SebiSebi/PM_project_F8_car/results/Pirtoaca_GeorgeSebastian_20170520_212222.jpg

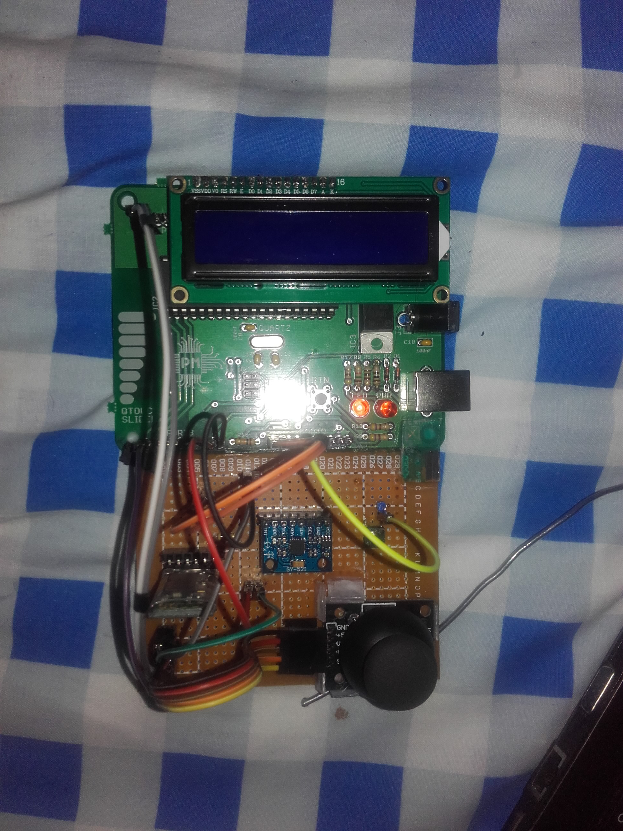
results/Pirtoaca_GeorgeSebastian_20170520_212222.jpg
