SebiSebi/PM_project_F8_car/M3/Milestone3_Pirtoaca_GeorgeSebastian_335CB.pdf

2017/05/13 23:45 | 1/5 | George-Sebastian PÎRTOAC (66847) - Fast and Furious


PM Wiki - http://cs.curs.pub.ro/wiki/pm/

# George-Sebastian PÎRTOAC (66847) - Fast and Furious

Autorul poate fi contactat la adresa: gpirtoaca@gmail.com

## Introducere

Proiectul are ca scop realizarea unei masinute cu telecomanda ce detecteaza obstacolele frontale si nu permite accidente in acest sens. De asemenea, masinuta va dispune si de un claxon pentru atentionarea diferitelor situatii in trafic . Controlul masinii se va face prin inclinarea telecomenzii in anumite unghiuri si pe anumite directii (alese in mod natural, pentru un control cat mai facil). De asemenea, restul comenzilor catre masinuta (precum claxon) se vor da tot cu ajutorul unor butoane plasate pe telecomanda. Comunicatia intre telecomanda si masinuta se va realiza prin tehnologia Bluetooth. Ideea acestui proiect provine din seria de filme de actiune The Fast and the Furious (https://en.wikipedia.org/wiki/The_Fast_and_the_Furious) a carei ultima pelicula abia a fost lansata in cinematografe. Proiectul este util pentru a invata cum se interfateaza diferitele componente pe care le voi utiliza (precum modulul de Bluetooth) cu un microcontroler dar si pentru a-mi cultiva pasiunea pentru masini

## Descriere general

Fig. 1: Schema bloc pentru telecomanda

Comunicatia intre microcontroler si modulul de bluetooth se face prin interfata seriala USART. Modulul de Bluetooth lucreaza in modul master si transmite comenzi cate modulul de Bluetooth de pe masinuta (care, implicit, va fi slave). Periodic, uC citeste datele de la accelerometru, folosind pinii conectati la convertorul analogic-digital, pentru a sesiza eventualele schimbari si pentru a transmite comenzile corespunzatoare catre microcontrolerul de pe masinuta. Microcontrolerul va lua decizii pe baza a doua unghiuri pe care acesta le poate masura (unghiul din planul XoY nu poate fi masurat doar

Last
update:
2017/05/13
23:41

prj2017:anitu:masinuta_pirtoaca_george_sebastian_335cb_2017 http://cs.curs.pub.ro/wiki/pm/prj2017/anitu/masinuta_pirtoaca_george_sebastian_335cb_2017


http://cs.curs.pub.ro/wiki/pm/ | Printed on 2017/05/13 23:45

pe baza accelerometrului, dar doua unghiuri sunt suficiente). Pentru mai multe detalii se pot consulta: Unghiurile lui Euler (https://en.wikipedia.org/wiki/Euler_angles) si Axele unui avion. (https://en.wikipedia.org/wiki/Aircraft_principal_axes) Unul dintre aceste unghiuri va da acceleratia masinii iar celalat directia. Date importante vor fi afisate pe LCD (in functie si de timpul extra de care dispun pentru implementarea proiectului pot sa adaug anumite feature-uri bonus precum: masurarea vitezei masinii, muzica la bord).

Fig. 2: Schema bloc pentru masina

Masinuta va avea 4 motoare (2 fata si 2 spate) - 4×4 iar directia se va modifica prin schimbarea vitezei de rotatie a rotilor de pe o parte sau alta a masinii. Pentru a asigura curentul necesar consumat de cele 4 motoare am ales sa folosesc driverul L298N. Acesta trebuie alimentat la o tensiune mai mare sau egala cu 9V (eu am ales sa folosesc 12V) si poate fi controlat folosind PWM pentru a modifica turatia motoarelor. Modulul de Bluetooth lucreaza in mod slave si asteapta date de la telecomanda. Microcontrolerul discuta cu un sensor de distanta (care va fi amplasat frontal) pentru a putea evita eventualele coliziuni ale masinutei (cand se detecteaza obiecte la o anumita distanta, aproximativ 20cm, masinuta nu va mai inainta). Buzzer-ul este folosit pentru implementarea claxonului.

## Hardware Design

Lista de piese:

2017/05/13 23:45 | 3/5 | George-Sebastian PÎRTOAC (66847) - Fast and Furious
Nume | Distribuitor
Placa de baza PM 2017 | Echipa PM
Modul Bluetooth HC-05 | Optimus Digital (https://www.optimusdigital.ro/wireless-bluetooth/153-modul-bluetooth-master-slave-hc-05-cu-adaptor.html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)
Motor cu reductor, cuplu 0.8 kg * cm | Optimus Digital
Buzzer | Optimus Digital (https://www.optimusdigital.ro/audio-buzzere/633-buzzer-activ-de-5-v.html?search_query=buzzer&results=20)
Driver motoare L298N | Optimus Digital (https://www.optimusdigital.ro/drivere-de-motoare-cu-perii/145-driver-de-motoare-dual-l298n.html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)
Senzor ultrasonic HC-SR04 | Optimus Digital (https://www.optimusdigital.ro/senzori-senzori-ultrasonici/9-senzor-ultrasonic-hc-sr04-.html)
LCD 16×2 | Robofun (https://www.robofun.ro/lcd/lcd-16x2-alb-albastru-3v)
Sasiu si roti | Optimus Digital (https://www.optimusdigital.ro/robotica-kit-uri-de-roboti/2042-kit-robot-cu-4-motoare-albastru.html)
Fire mama-mama | Optimus Digital (https://www.optimusdigital.ro/fire-fire-mufate/883-set-fire-mama-mama-10p-30-cm.html)
Fire mama-tata | Optimus Digital (https://www.optimusdigital.ro/fire-fire-mufate/879-set-fire-mama-tata-10p-30-cm.html)
Rezistente | Optimus Digital
Condensatoare | Optimus Digital
Acumulatori | Optimus Digital
Modul Accelerometru Digital MMA8452 Optimus Digital (https://www.optimusdigital.ro/senzori-senzori-inertiali/748-modul-accelerometru-digital-mma8452.html)

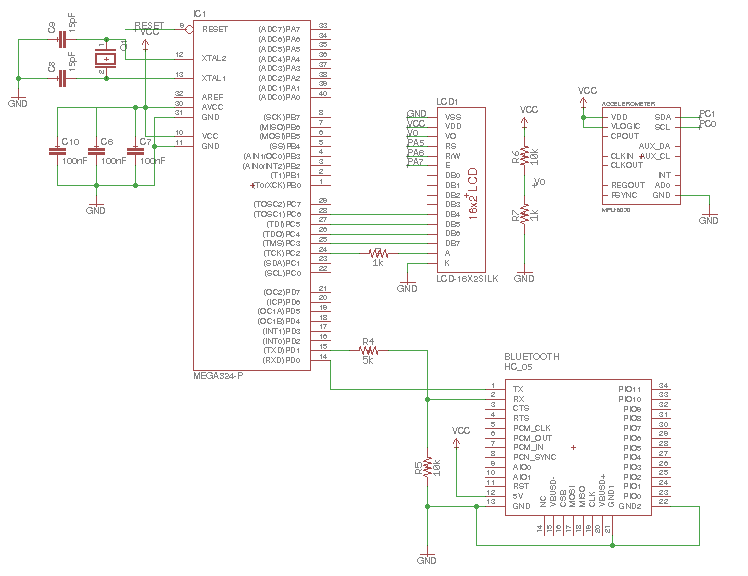
[picture p6: figure]

Fig. 3: Schema electrica pentru telecomanda

Last
update:
2017/05/13
23:41

prj2017:anitu:masinuta_pirtoaca_george_sebastian_335cb_2017 http://cs.curs.pub.ro/wiki/pm/prj2017/anitu/masinuta_pirtoaca_george_sebastian_335cb_2017

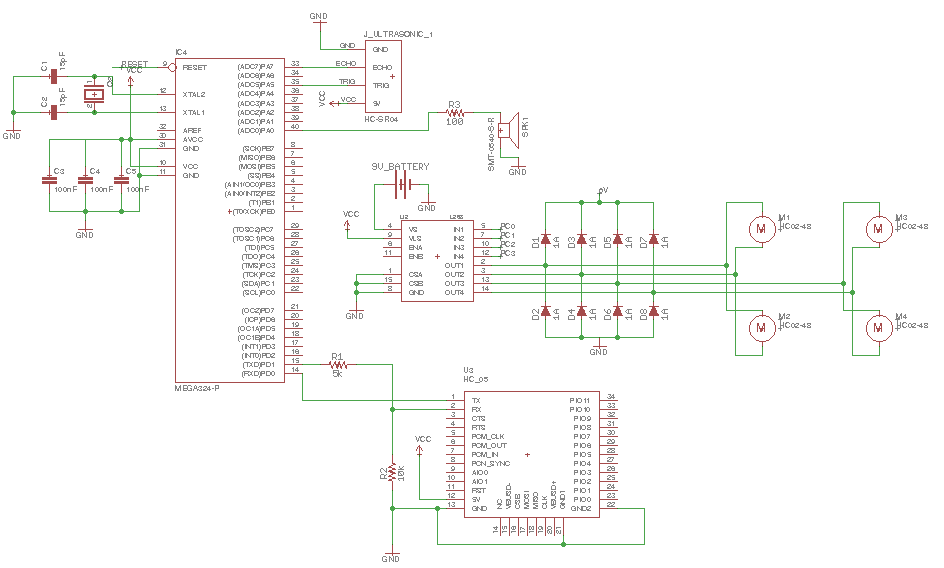
[picture p7: figure]

http://cs.curs.pub.ro/wiki/pm/ | Printed on 2017/05/13 23:45

Fig. 4: Schema electrica pentru masina

## Software Design

Descrierea codului aplicaiei (firmware):

- mediu de dezvoltare (if any) (e.g. AVR Studio, CodeVisionAVR)
- librrii i surse 3rd-party (e.g. Procyon AVRlib)
- algoritmi i structuri pe care plnuii s le implementai
- (etapa 3) surse i funcii implementate

## Rezultate Obinute

Care au fost rezultatele obinute în urma realizrii proiectului vostru.

## Concluzii

2017/05/13 23:45 | 5/5 | George-Sebastian PÎRTOAC (66847) - Fast and Furious

## Download

O arhiv (sau mai multe dac este cazul) cu fiierele obinute în urma realizrii proiectului: surse, scheme, etc. Un fiier README, un ChangeLog, un script de compilare i copiere automat pe uC creaz întotdeauna o impresie bun .

Fiierele se încarc pe wiki folosind facilitatea Add Images or other files. Namespace-ul în care se încarc fiierele este de tipul :pm:prj20??:c? sau :pm:prj20??:c?:nume_student (dac este cazul). Exemplu: Dumitru Alin, 331CC :pm:prj2017:avoinescu:dumitru_alin.

## Jurnal

Putei avea i o seciune de jurnal în care s poat urmri asistentul de proiect progresul proiectului.

## Bibliografie/Resurse

List cu documente, datasheet-uri, resurse Internet folosite, eventual grupate pe Resurse Software i Resurse Hardware.

- Documentaia în format PDF (http://cs.curs.pub.ro/?do=export_pdf)

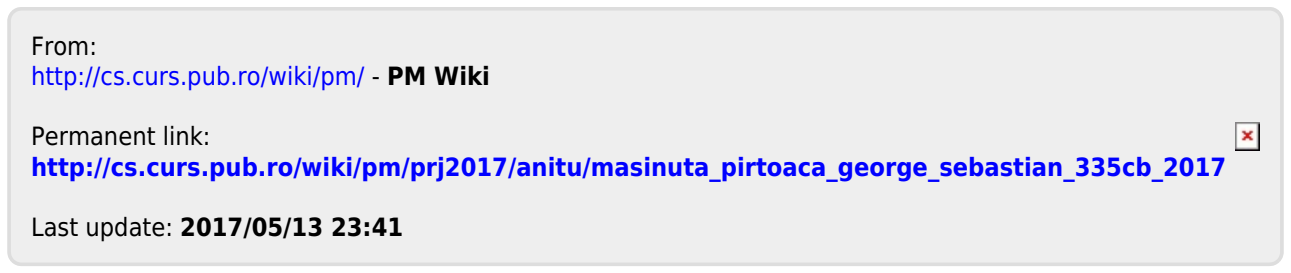
[picture p8: figure]
From: http://cs.curs.pub.ro/wiki/pm/ - PM Wiki; Permanent link: http://cs.curs.pub.ro/wiki/pm/prj2017/anitu/masinuta_pirtoaca_george_sebastian_335cb_2017; Last update: 2017/05/13 23:41
