SebiSebi/PM_project_F8_car/M1/Pirtoaca_GeorgeSebastian_block_diagram_remote.png

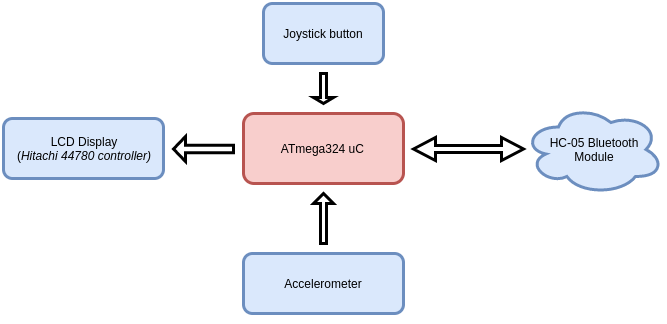
M1/Pirtoaca_GeorgeSebastian_block_diagram_remote.png
