SebiSebi/PM_project_F8_car/M2/Pirtoaca_GeorgeSebastian_schema_remote.png

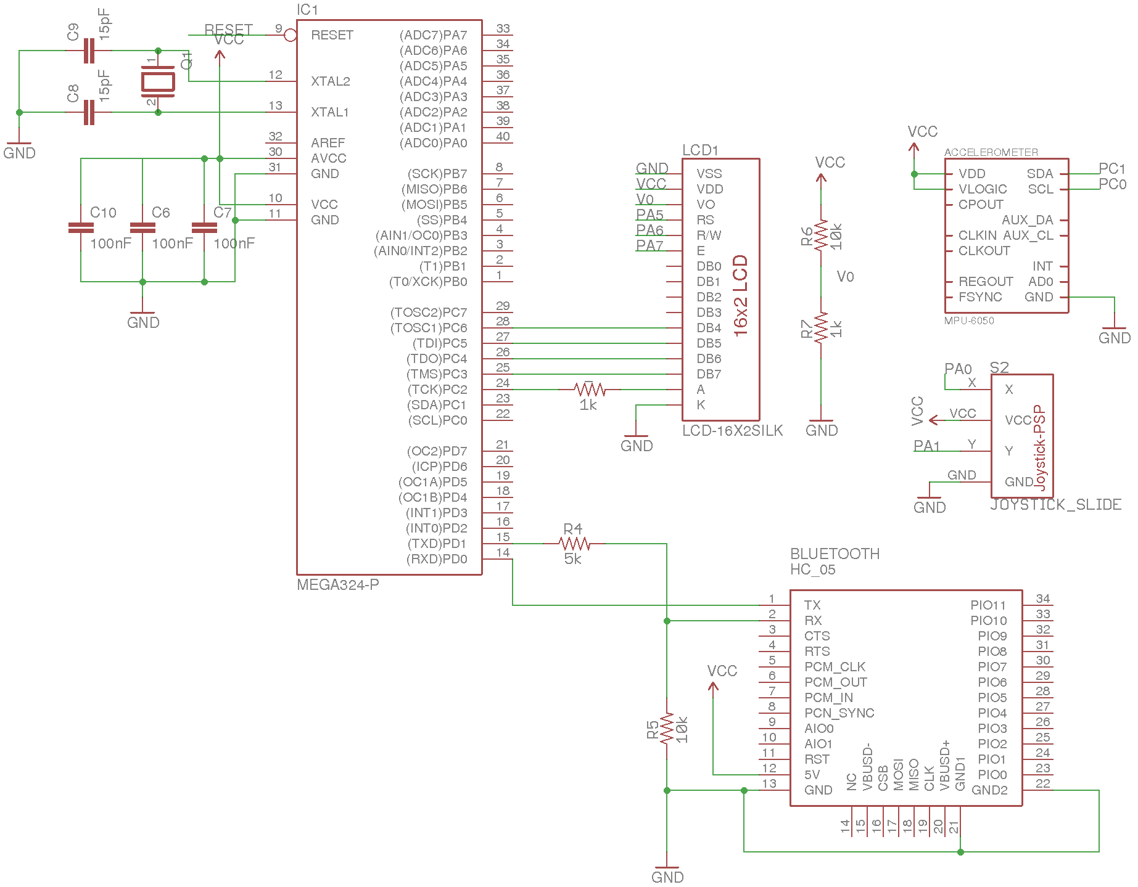
M2/Pirtoaca_GeorgeSebastian_schema_remote.png
