SebiSebi/PM_project_F8_car/results/Pirtoaca_GeorgeSebastian_20170520_212150.jpg

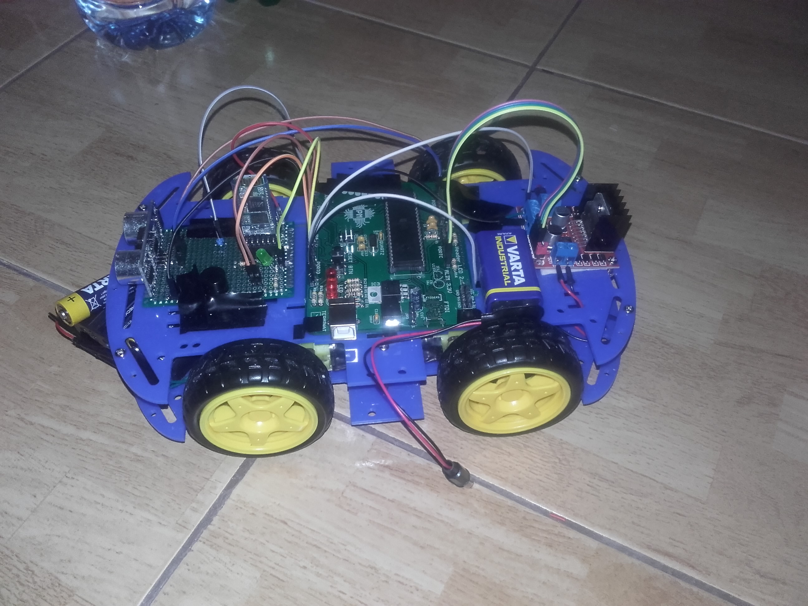
results/Pirtoaca_GeorgeSebastian_20170520_212150.jpg
