SebiSebi/PM_project_F8_car/M2/pm2017.sch

## EAGLE design M2/pm2017.sch (2017-05-24)

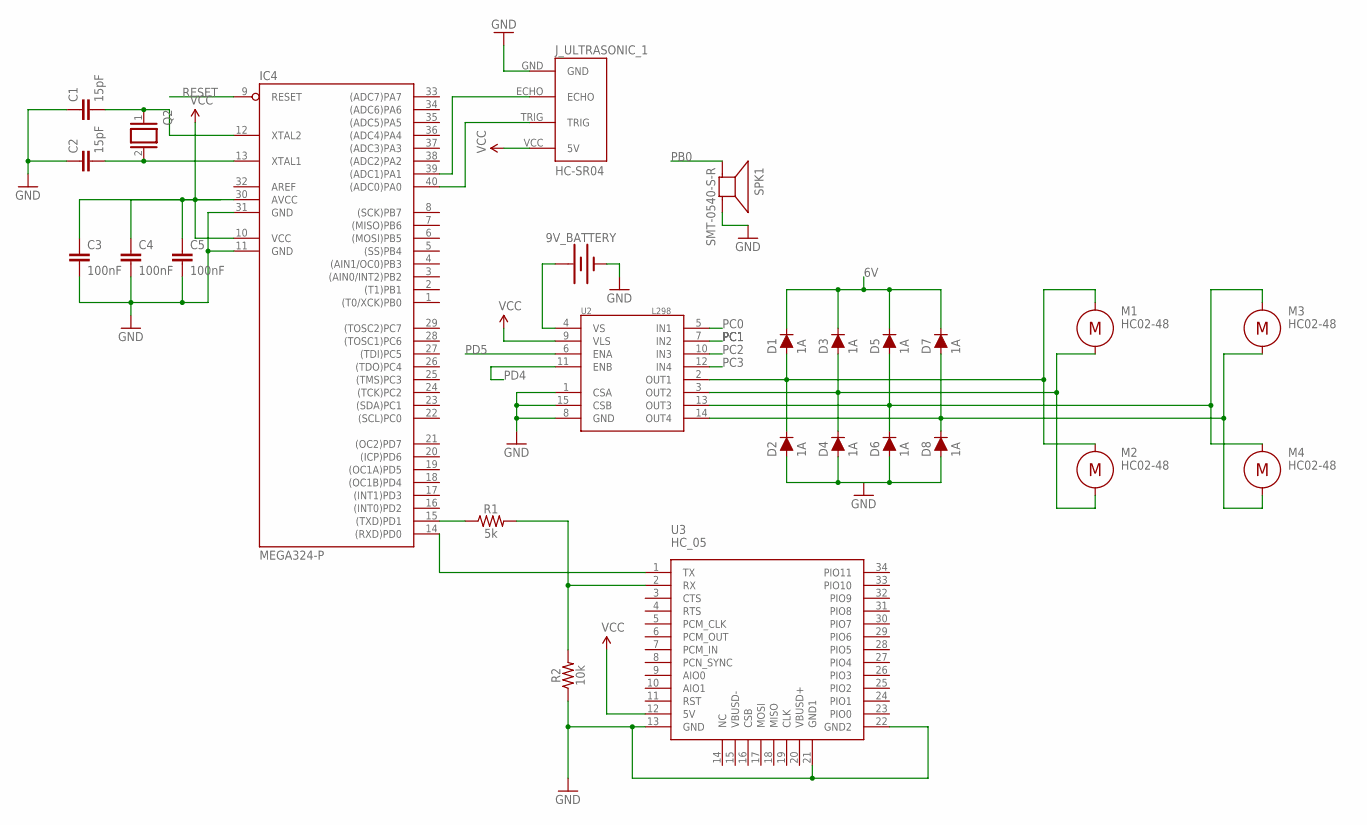
[picture p16: schematic pm2017.sch, sheet 1]

Parts:
9V_BATTERY: BATTERY-9V; BATTCON_9V
C1, C2: 15pF; C025-025X050
C3, C4, C5: 100nF; C025-025X050
D1, D2, D3, D4, D5, D6, D7, D8: 1A; DIODE-1N4001
IC4: MEGA324-P; DIL40
J_ULTRASONIC_1: HC-SR04; HC-SR04_FOOTPRINT
Q2: XTAL/S; QS
R1: 5k; 0603
R2: 10k; AXIAL-0.3
SPK1: SMT-0540-S-R
U2: L298; MULTIWATT15
U3: HC_05; BLUETOOTH_SMD

Connections:
6V: D1.C, D3.C, D5.C, D7.C
6V1: D1.A, D2.C, U2.2 (OUT1)
GND: 9V_BATTERY.-, C1.1, C2.1, C3.2, C4.2, C5.2, IC4.11 (GND), IC4.31 (GND), J_ULTRASONIC_1.GND, R2.P$1 (1), SPK1.+ (-), U2.1 (CSA), U2.8 (GND), U2.15 (CSB), U3.13 (GND), U3.21 (GND1), U3.22 (GND2)
unnamed: C3.1, IC4.30 (AVCC)
unnamed: C2.2, IC4.13 (XTAL1), Q2.2
unnamed: C1.2, IC4.12 (XTAL2), Q2.1
unnamed: IC4.40 ((ADC0)PA0), J_ULTRASONIC_1.TRIG
unnamed: IC4.39 ((ADC1)PA1), J_ULTRASONIC_1.ECHO
unnamed: D5.A, D6.C, U2.13 (OUT3)
unnamed: 9V_BATTERY.+, U2.4 (VS)
unnamed: D7.A, D8.C, U2.14 (OUT4)
unnamed: D3.A, D4.C, U2.3 (OUT2)
unnamed: IC4.14 ((RXD)PD0), U3.1 (TX)
unnamed: D2.A, D4.A, D6.A, D8.A
unnamed: IC4.15 ((TXD)PD1), R1.1
unnamed: R1.2, R2.P$2 (2), U3.2 (RX)
PB0: SPK1.- (+)
PC0: U2.5 (IN1)
PC1: U2.7 (IN2)
PC2: U2.10 (IN3)
PC3: U2.12 (IN4)
PD4: U2.11 (ENB)
PD5: U2.6 (ENA)
RESET: IC4.9 (RESET)
VCC: C4.1, C5.1, IC4.10 (VCC), J_ULTRASONIC_1.VCC (5V), U2.9 (VLS), U3.12 (5V)

Notes on the sheet:
HC02-48

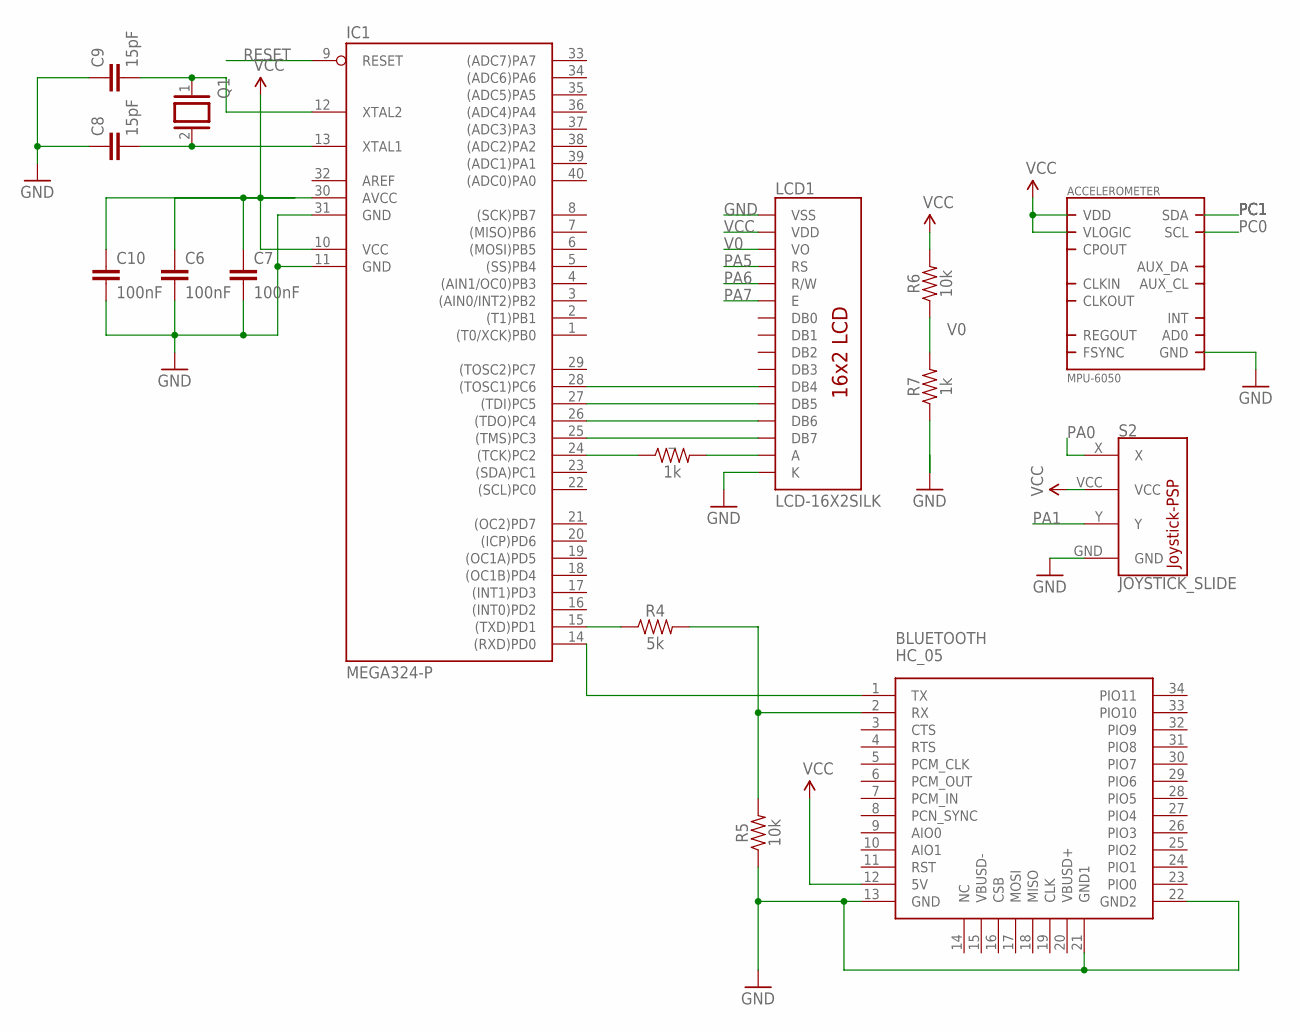
[picture p17: schematic pm2017.sch, sheet 2]

Parts:
ACCELEROMETER: MPU-6050; QFN.24.4X4
BLUETOOTH: HC_05; BLUETOOTH_SMD
C6, C7, C10: 100nF; C025-025X050
C8, C9: 15pF; C025-025X050
IC1: MEGA324-P; DIL40
LCD1: LCD-16X2SILK; LCD-16X2
Q1: XTAL/S; QS
R4: 5k; 0603
R5, R6: 10k; AXIAL-0.3
R7: 1k; AXIAL-0.3
S2: JOYSTICK_SLIDE; JOYSTICK-PSP1000
_: 1k; AXIAL-0.3

Connections:
GND: ACCELEROMETER.18 (GND), BLUETOOTH.13 (GND), BLUETOOTH.21 (GND1), BLUETOOTH.22 (GND2), C6.2, C7.2, C8.1, C9.1, C10.2, IC1.11 (GND), IC1.31 (GND), LCD1.1 (VSS), LCD1.16 (K), R5.P$1 (1)
unnamed: C10.1, IC1.30 (AVCC)
unnamed: C8.2, IC1.13 (XTAL1), Q1.2
unnamed: C9.2, IC1.12 (XTAL2), Q1.1
unnamed: BLUETOOTH.1 (TX), IC1.14 ((RXD)PD0)
unnamed: BLUETOOTH.2 (RX), R4.2, R5.P$2 (2)
unnamed: IC1.15 ((TXD)PD1), R4.1
unnamed: IC1.28 ((TOSC1)PC6), LCD1.11 (DB4)
unnamed: IC1.27 ((TDI)PC5), LCD1.12 (DB5)
unnamed: IC1.26 ((TDO)PC4), LCD1.13 (DB6)
unnamed: IC1.25 ((TMS)PC3), LCD1.14 (DB7)
unnamed: LCD1.15 (A), _.P$2 (2)
unnamed: IC1.24 ((TCK)PC2), _.P$1 (1)
PA0: S2.X
PA1: S2.Y
PA5: LCD1.4 (RS)
PA6: LCD1.5 (R/W)
PA7: LCD1.6 (E)
PC0: ACCELEROMETER.23 (SCL)
PC1: ACCELEROMETER.24 (SDA)
RESET: IC1.9 (RESET)
V0: LCD1.3 (VO), R6.P$1 (1), R7.P$2 (2)
VCC: ACCELEROMETER.8 (VLOGIC), ACCELEROMETER.13 (VDD), BLUETOOTH.12 (5V), C6.1, C7.1, IC1.10 (VCC), LCD1.2 (VDD), R6.P$2 (2)
