SebiSebi/PM_project_F8_car/(commit log)

2017-05-20 Added accelerometer and HC_SR04 stability
    [HC_SR04.c, HC_SR04.h, motor.c, remote.c]
2017-05-24 Added M1 directory
    [pm2017.sch]
2017-05-24 Added M2 data
    [pm2017.sch]
