SebiSebi/PM_project_F8_car/(notices)

Notices in the files:
parts and their libraries:
SparkFun-IC-Special-Function: Licensing: Creative Commons ShareAlike 4.0 International - https://creativecommons.org/licenses/by-sa/4.0
